leocelente/vedderb_bldc_hardware/design/BLDC_4.ods

Id | Designator | Footprint | Quantity | Designation | Supplier and ref
1 | D5 | do214ac | 1 | TVS 5V | 576-SMAJ5.0A
2 | C25,C33 | c_tant_B | 2 | 100u 6.3V | 581-TPSB107K006R0400
3 | C1,C8,C9,C40,C43,C44,C49 | SMD-1206 | 7 | 10u,50V | CAP SMD 1206
4 | C37 | c_2220 | 1 | 15u,100V | 810-CGA9P3X7S2A156M
5 | C51 | c_2220 | 1 | 15u, 100v | 810-CGA9P3X7S2A156M
6 | U2 | SOT-223 | 1 | TC2117 | 579-TC2117-3.3VDBTR
7 | R1 | SMD-0603_r | 1 | NTC 10k | 81-NCP18XH103F03RB
8 | R2,R20,R7,R8,R9,R10,R402 | SMD-0603_r | 7 | 10k | RES SMD 0603
9 | R17 | SMD-0603_r | 1 | 18k | RES SMD 0603
10 | R18 | SMD-0603_r | 1 | 3k3 | RES SMD 0603
11 | R19 | SMD-0603_r | 1 | 15k | RES SMD 0603
12 | R25 | SMD-0603_r | 1 | 1M | RES SMD 0603
13 | R28,R34,R42,R29,R35,R43 | SMD-0603_r | 6 | 4R7 | RES SMD 0603
14 | R48,R49,R50,R51,R16,R31,R37,R38 | SMD-0603_r | 8 | 100R | RES SMD 0603
15 | R103,R104 | SMD-0603_r | 2 | 22R | RES SMD 0603
16 | R401 | SMD-0603_r | 1 | 120R | RES SMD 0603
17 | R47,R39,R40,R45,R3,R23,R26,R30,R32,R36,R46 | SMD-0603_r | 11 | 39k | RES SMD 0603
18 | R4,R5,R11,R12,R13,R22,R24,R27,R33 | SMD-0603_r | 9 | 2k2 | RES SMD 0603
19 | R6 | SMD-0603_r | 1 | 0R | RES SMD 0603
20 | R21 | SMD-0603_r | 1 | 220k | RES SMD 0603
21 | R53,R52,R15,R14 | YLR2512_G4 | 4 | YLR12-3-8F-W
22 | Q1,Q3,Q5,Q6,Q2,Q4 | D2PAK-7-GDS | 6 | IRFS7530 | 942-IRFS7530TRL7PP
23 | K1 | PinHeader_1x03_P2.54mm_Horizontal | 1 | SERVO | Barra de pinos simples horizontal 2.54mm
24 | P2 | JST_PH_B6B-PH-K_1x06_P2.00mm_Vertical | 1 | SWD | JST PH 6 vias 2mm sinlge Vertical
25 | U1 | lqfp64_pad_mod | 1 | STM32F40X_LQFP64 | 511-STM32F405RGT6
26 | U3 | TSSOP-56-PP | 1 | DRV8302 | 595-DRV8302DCA
27 | P101 | JST_PH_S4B-PH-K_1x04_P2.00mm_Horizontal | 1 | CANBUS | JST PH 4 vias 2mm single horizontal
28 | C10,C11,C12,C13,C23,C35,C41,C401,C14,C16,C17,C18,C20,C24,C31,C52,C26 | SMD-0603_c | 17 | 2.2u 16V | 810-C1608X5R1C225M
29 | C19 | SMD-0603_c | 1 | 120p 50V | CAP SMD 0603
30 | C21 | SMD-0603_c | 1 | 6.8n 50V | CAP SMD 0603
31 | C22 | SMD-0603_c | 1 | 22n 50V | CAP SMD 0603
32 | C27,C47,C42,C2,C3,C32 | SMD-0603_c | 6 | 100n 50V | CAP SMD 0603
33 | C28,C29,C30 | SMD-0603_c | 3 | 220n 25V | CAP SMD 0603
34 | C34,C36 | SMD-0603_c | 2 | 2.2n 50V | CAP SMD 0603
35 | C39 | C_1206_3216Metric_Pad1.33x1.80mm_HandSolder | 1 | 10u,50V | 963-UMK316BBJ106ML-T
36 | U401 | SOIC-8-W | 1 | SN65HVD232DR
37 | X1 | USB-UX60R-MB-5ST | 1 | MINI-USB-SHIELD-32005-201 | 798-UX60R-MB-5ST
38 | P3 | JST_PH_S4B-PH-K_1x04_P2.00mm_Horizontal | 1 | PWR_COMM | JST PH 4 vias 2mm single horizontal
39 | L1 | inductor_smd_8x5mm | 1 | 22u | 652-SDR0805-220ML
40 | U8 | SOIC-8_3.9x4.9mm_P1.27mm | 1 | MAX485ED
41 | C45,C46 | SMD-0603_c | 2 | 10n 50V | CAP SMD 0603
42 | J3 | JST_PHD_S12B-PHDSS_2x06_P2.00mm_Horizontal | 1 | Conn_02x06_Odd_Even | JST PHD 12 vias 2mm duplo Horizontal
43 | U4,U7 | SOIC-8_3.9x4.9mm_P1.27mm | 2 | INA826AIDR
44 | J5,J4 | PinHeader_1x01_P1.00mm_Vertical | 2 | Conn_01x01_Pin | pin header 1 via vertical
45 | U5 | SOIC-16_3.9x9.9mm_P1.27mm | 1 | AM26C32CD
46 | FB1 | R_0805_2012Metric | 1 | FerriteBead | BLM31KN102SZ1L
47 | J1 | PhoenixContact_MSTBA_2,5_3-G-5,08_1x03_P5.08mm_Horizontal | 1 | Conn_01x03 | PhoenixContact_MSTBA_2,5_3-G-5,08_1x03_P5.08mm_Horizontal
48 | U6,U9 | SOT-23-5 | 2 | OPA333AIDBVR
49 | J6 | JST_PH_S2B-PH-K_1x02_P2.00mm_Horizontal | 1 | Conn_02x06_Odd_Even | JST PH 2 vias 2mm single horizontal
50 | J2 | PhoenixContact_MSTBA_2,5_2-G-5,08_1x02_P5.08mm_Horizontal | 1 | Conn_01x02 | PhoenixContact_MSTBA_2,5_2-G-5,08_1x02_P5.08mm_Horizontal
51 | D1 | LED-0603 | 1 | GREEN | LED GREEN 0603
52 | D2 | LED-0603 | 1 | RED | LED RED 0603
53 | D3 | LED-0603 | 1 | LED | LED yELLOW 0603
54 | X2 | Crystal_5x3mm | 1 | 8MHz 10ppm | 815-ABM3B-8.0-10-1UT
55 | C4,C5,C6,C7 | SMD-0603_c | 4 | 4n7 50V | CAP SMD 0603
56 | C15,C38 | SMD-0603_c | 2 | 15p 100V | CAP SMD 0603
57 | D4 | SMA_Handsoldering | 1 | DIODESCH | 771-PMEG6020ER-115
58 | R41,R44 | SMD-0603_r | 2 | 5.1K 0.1% | RT0603BRD075K1L
