leocelente/vedderb_bldc_hardware/design/BLDC_4.kicad_pcb

## KiCad design design/BLDC_4.kicad_pcb (2023-03-11)

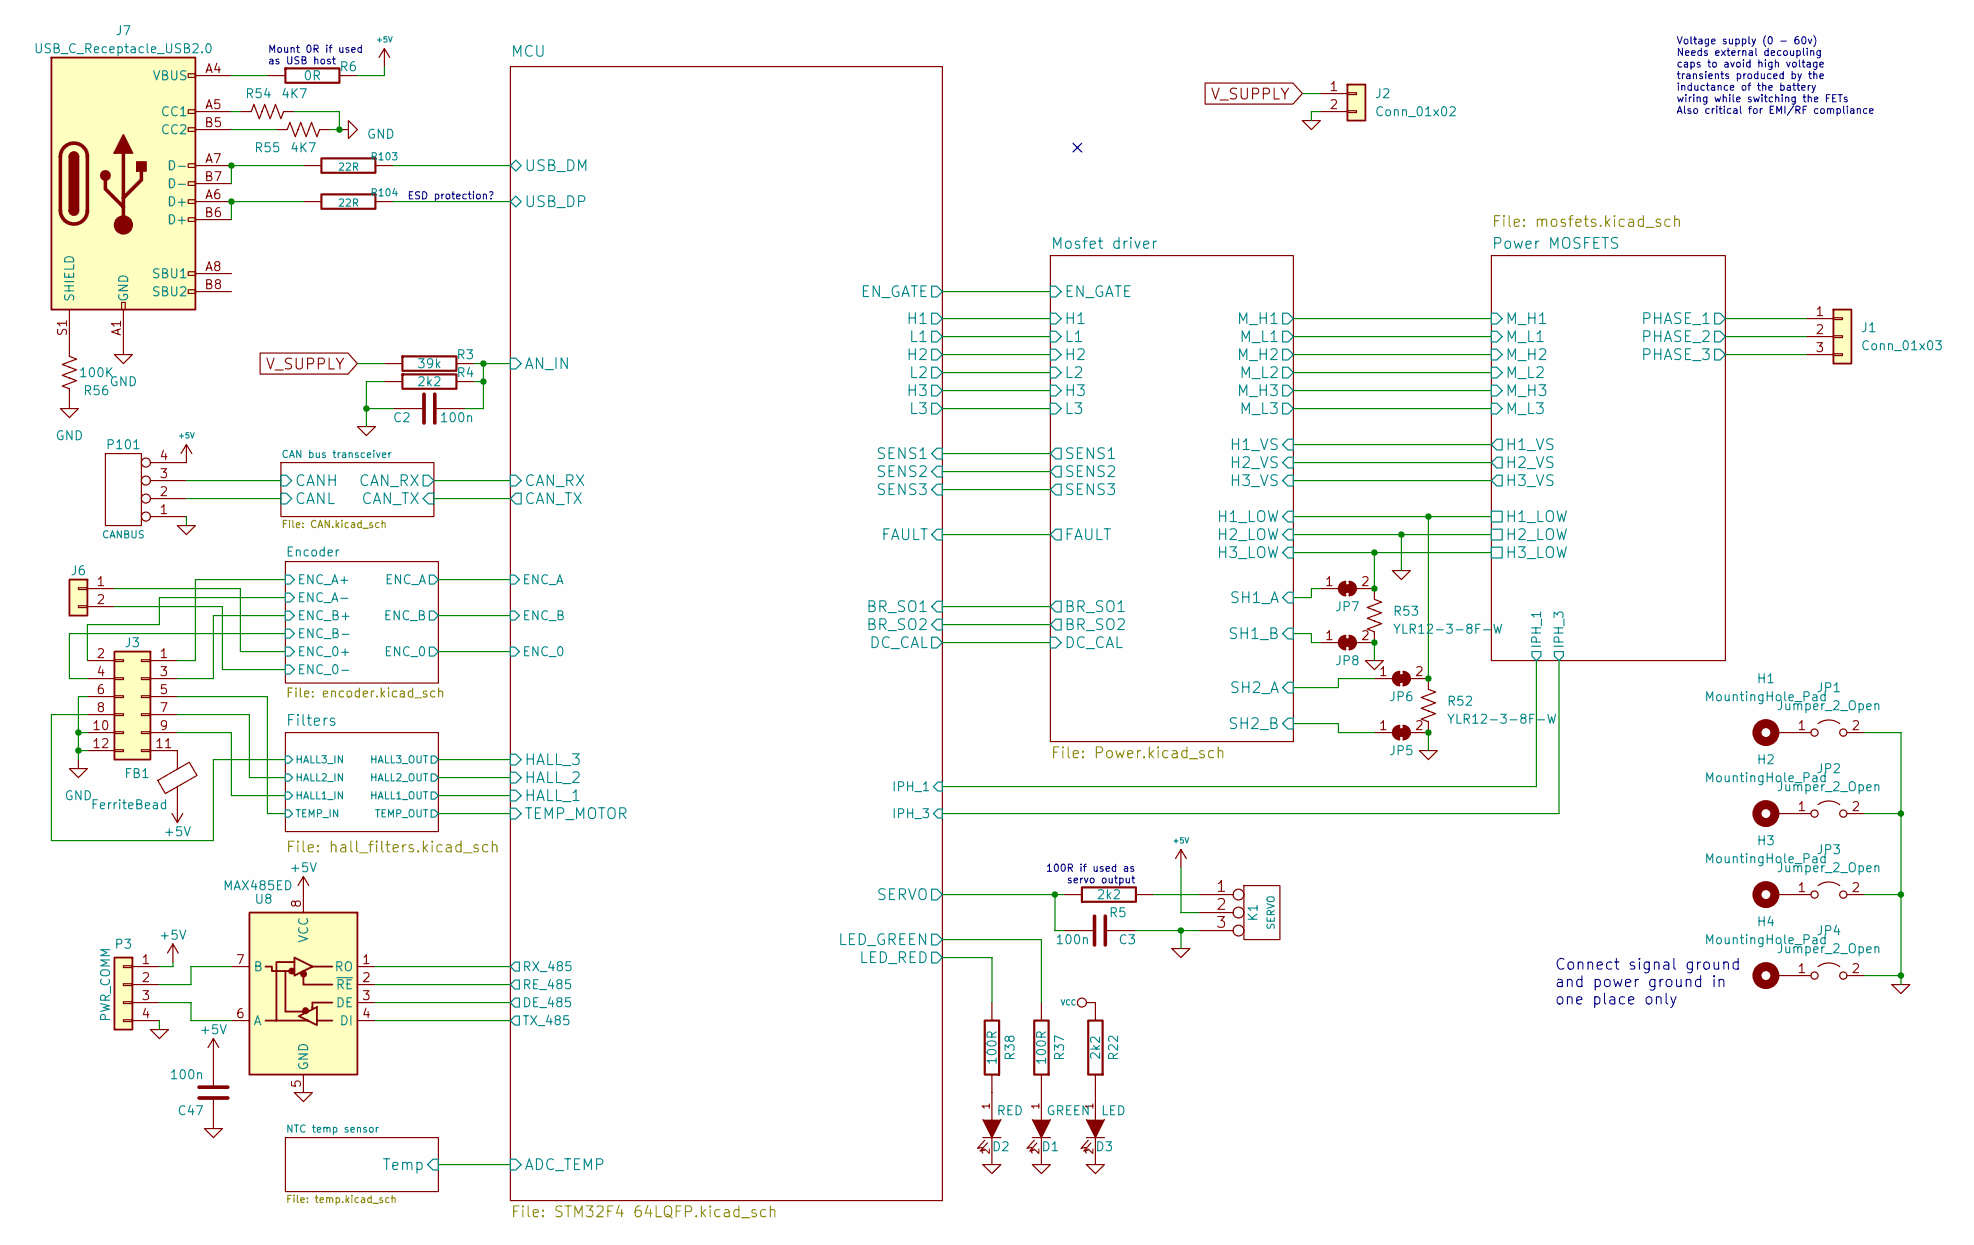
[picture p1: schematic BLDC_4.kicad_sch, BLDC Driver 4.11]

Parts:
C2, C3, C47: 100n; SMD-0603_c
D1: GREEN; LED-0603
D2: RED; LED-0603
D3: LED; LED-0603
FB1: FerriteBead; R_0805_2012Metric
H1, H2, H3, H4: MountingHole_Pad; MountingHole_3.2mm_M3_ISO7380_Pad
J1: Conn_01x03; PhoenixContact_MSTBA_2,5_3-G-5,08_1x03_P5.08mm_Horizontal
J2: Conn_01x02; PhoenixContact_MSTBA_2,5_2-G-5,08_1x02_P5.08mm_Horizontal
J3: Conn_02x06_Odd_Even; JST_PHD_S12B-PHDSS_2x06_P2.00mm_Horizontal
J6: Conn_02x06_Odd_Even; JST_PH_S2B-PH-K_1x02_P2.00mm_Horizontal
J7: USB_C_Receptacle_USB2.0; USB_C_Receptacle_G-Switch_GT-USB-7010ASV
JP1, JP2, JP3, JP4: Jumper_2_Open; SolderJumper-2_P1.3mm_Open_Pad1.0x1.5mm
JP5, JP6, JP7, JP8: SolderJumper_2_Bridged; MicroNetSep
K1: SERVO; PinHeader_1x03_P2.54mm_Horizontal
P3: PWR_COMM; JST_PH_S4B-PH-K_1x04_P2.00mm_Horizontal
P101: CANBUS; JST_PH_S4B-PH-K_1x04_P2.00mm_Horizontal
R3: 39k; SMD-0603_r
R4, R5, R22: 2k2; SMD-0603_r
R6: 0R; SMD-0603_r
R37, R38: 100R; SMD-0603_r
R52, R53: YLR12-3-8F-W; YLR2512_G4
R54, R55: 4K7; R_0603_1608Metric_Pad0.98x0.95mm_HandSolder
R56: 100K; R_0603_1608Metric_Pad0.98x0.95mm_HandSolder
R103, R104: 22R; SMD-0603_r
U8: MAX485ED; SOIC-8_3.9x4.9mm_P1.27mm

Connections:
+5V: C47.2, FB1.1, K1.2 (PM), P3.1, P101.4, R6.2, U8.8 (VCC); also elsewhere on the board
/CAN bus transceiver/CANH: P101.3; also elsewhere on the board
/CAN bus transceiver/CANL: P101.2; also elsewhere on the board
/Encoder/ENC_0+: J6.1; also elsewhere on the board
/Encoder/ENC_0-: J6.2; also elsewhere on the board
/Encoder/ENC_A+: J3.1; also elsewhere on the board
/Encoder/ENC_A-: J3.2; also elsewhere on the board
/Encoder/ENC_B+: J3.3; also elsewhere on the board
/Encoder/ENC_B-: J3.4; also elsewhere on the board
/Filters/HALL1_IN: J3.9; also elsewhere on the board
/Filters/HALL2_IN: J3.7; also elsewhere on the board
/Filters/HALL3_IN: J3.8; also elsewhere on the board
/Filters/TEMP_MOTOR: J3.5; also elsewhere on the board
/MCU/AN_IN: C2.2, R3.2, R4.2; also elsewhere on the board
/MCU/DE_485: U8.3 (DE); also elsewhere on the board
/MCU/LED_GREEN: R37.2; also elsewhere on the board
/MCU/LED_RED: R38.2; also elsewhere on the board
/MCU/RE_485: U8.2 (~RE); also elsewhere on the board
/MCU/RX_485: U8.1 (RO); also elsewhere on the board
/MCU/SERVO: C3.2, R5.1; also elsewhere on the board
/MCU/TX_485: U8.4 (DI); also elsewhere on the board
/MCU/USB_DM: R103.1; also elsewhere on the board
/MCU/USB_DP: R104.1; also elsewhere on the board
/Mosfet driver/H1_LOW: JP6.2 (B), R52.1; also elsewhere on the board
/Mosfet driver/H2_VS: J1.2; also elsewhere on the board
/Mosfet driver/SH1_A: JP7.1 (A); also elsewhere on the board
/Mosfet driver/SH2_A: JP6.1 (A); also elsewhere on the board
/Mosfet driver/SH2_B: JP5.1 (A); also elsewhere on the board
/Power MOSFETS/PHASE_1: J1.1; also elsewhere on the board
/Power MOSFETS/PHASE_3: J1.3; also elsewhere on the board
unnamed: D1.1 (A), R37.1
unnamed: D2.1 (A), R38.1
unnamed: D3.1 (A), R22.1
unnamed: FB1.2, J3.11
unnamed: J7.A5 (CC1), R54.1
unnamed: J7.B5 (CC2), R55.1
unnamed: J7.A6 (D+), J7.B6 (D+), R104.2
unnamed: J7.A7 (D-), J7.B7 (D-), R103.2
unnamed: J7.S1 (SHIELD), R56.2
unnamed: J7.A4 (VBUS), J7.A9 (VBUS), J7.B4 (VBUS), J7.B9 (VBUS), R6.1
unnamed: H1.1, JP1.1 (A)
unnamed: H2.1, JP2.1 (A)
unnamed: H3.1, JP3.1 (A)
unnamed: H4.1, JP4.1 (A)
unnamed: K1.1, R5.2
unnamed: P3.2, U8.7 (B)
unnamed: P3.3, U8.6 (A)
VCC: R22.2; also elsewhere on the board
V_SUPPLY: J2.1, R3.1; also elsewhere on the board

Notes on the sheet:
100R if used as servo output
Voltage supply (0 - 60v) Needs external decoupling caps to avoid high voltage transients produced by the inductance of the battery wiring while switching the FETs Also critical for EMI/RF compliance
Connect signal ground and power ground in one place only
Mount 0R if used as USB host
ESD protection?

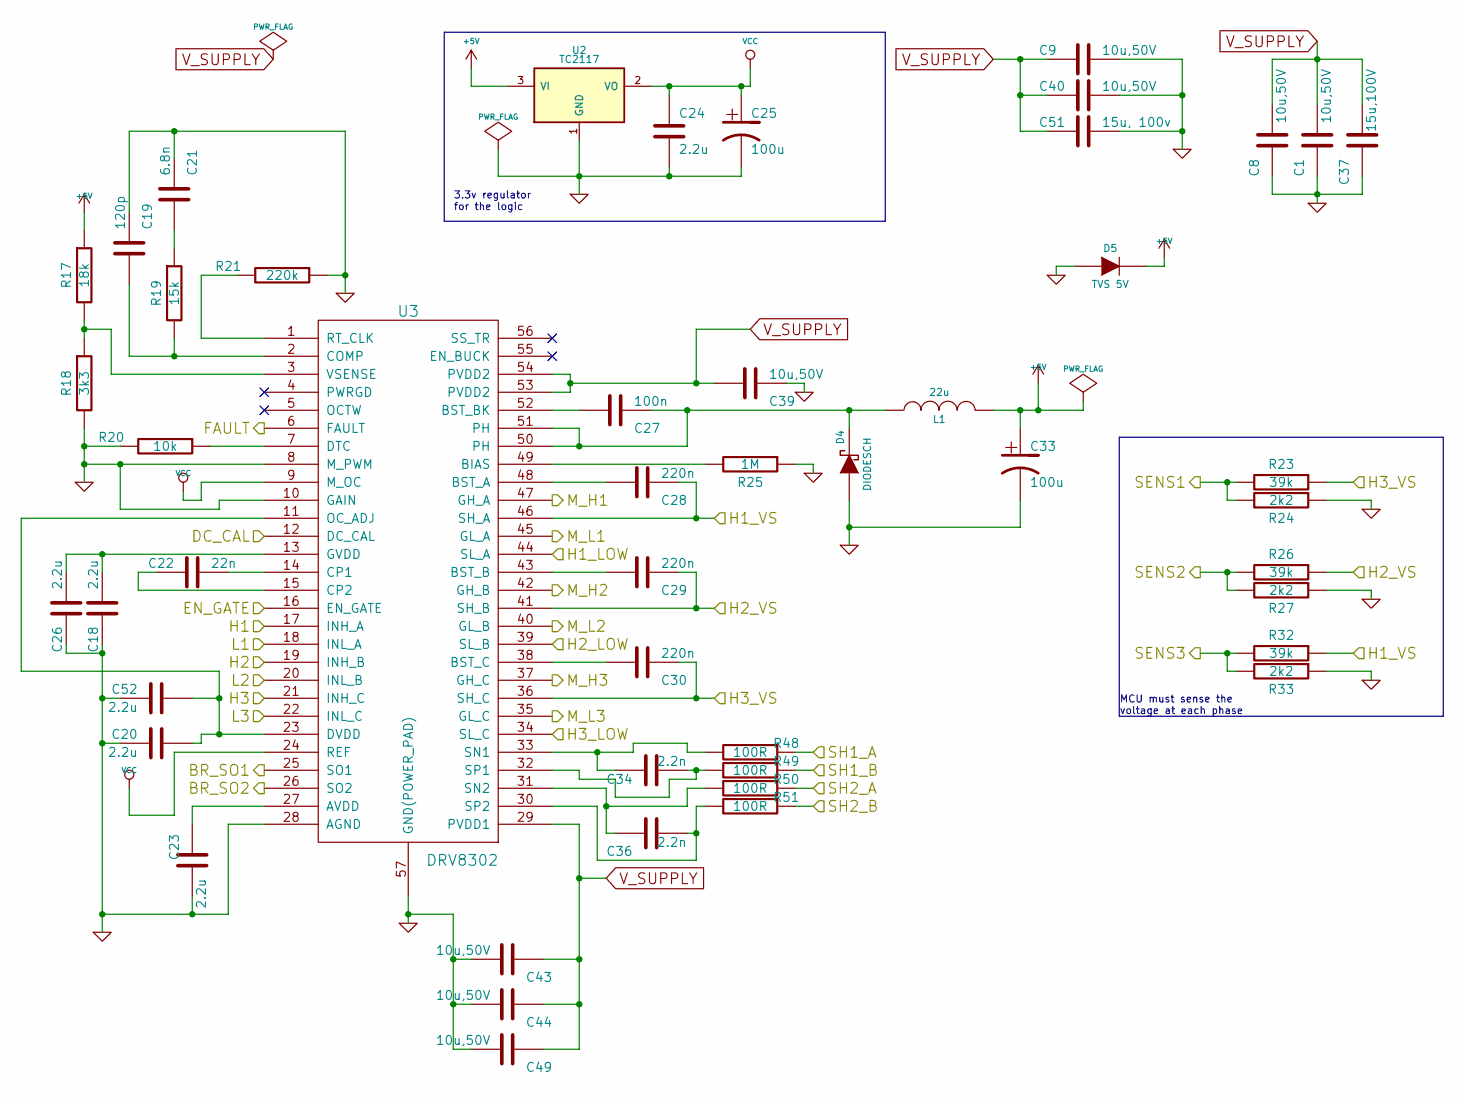
[picture p2: schematic Power.kicad_sch, BLDC Driver 4.11]

Parts:
C1, C8, C9, C40, C43, C44, C49: 10u,50V; SMD-1206
C18, C20, C23, C24, C26, C52: 2.2u; SMD-0603_c
C19: 120p; SMD-0603_c
C21: 6.8n; SMD-0603_c
C22: 22n; SMD-0603_c
C25, C33: 100u; c_tant_B
C27: 100n; SMD-0603_c
C28, C29, C30: 220n; SMD-0603_c
C34, C36: 2.2n; SMD-0603_c
C37: 15u,100V; c_2220
C39: 10u,50V; C_1206_3216Metric_Pad1.33x1.80mm_HandSolder
C51: 15u, 100v; c_2220
D4: DIODESCH; SMA_Handsoldering
D5: TVS 5V; do214ac
L1: 22u; inductor_smd_8x5mm
R17: 18k; SMD-0603_r
R18: 3k3; SMD-0603_r
R19: 15k; SMD-0603_r
R20: 10k; SMD-0603_r
R21: 220k; SMD-0603_r
R23, R26, R32: 39k; SMD-0603_r
R24, R27, R33: 2k2; SMD-0603_r
R25: 1M; SMD-0603_r
R48, R49, R50, R51: 100R; SMD-0603_r
U2: TC2117; SOT-223
U3: DRV8302; TSSOP-56-PP

Connections:
+5V: C33.1, D5.2 (K), L1.2, R17.1, U2.3 (VI); also elsewhere on the board
/MCU/BR_SO1: U3.25 (SO1); also elsewhere on the board
/MCU/BR_SO2: U3.26 (SO2); also elsewhere on the board
/MCU/DC_CAL: U3.12 (DC_CAL); also elsewhere on the board
/MCU/EN_GATE: U3.16 (EN_GATE); also elsewhere on the board
/MCU/FAULT: U3.6 (FAULT); also elsewhere on the board
/MCU/H1: U3.17 (INH_A); also elsewhere on the board
/MCU/H2: U3.19 (INH_B); also elsewhere on the board
/MCU/H3: U3.21 (INH_C); also elsewhere on the board
/MCU/L1: U3.18 (INL_A); also elsewhere on the board
/MCU/L2: U3.20 (INL_B); also elsewhere on the board
/MCU/L3: U3.22 (INL_C); also elsewhere on the board
/MCU/SENS1: R23.2, R24.2; also elsewhere on the board
/MCU/SENS2: R26.2, R27.2; also elsewhere on the board
/MCU/SENS3: R32.2, R33.2; also elsewhere on the board
/Mosfet driver/H1_LOW: U3.44 (SL_A); also elsewhere on the board
/Mosfet driver/H2_VS: C29.1, R26.1, U3.41 (SH_B); also elsewhere on the board
/Mosfet driver/M_H1: U3.47 (GH_A); also elsewhere on the board
/Mosfet driver/M_H2: U3.42 (GH_B); also elsewhere on the board
/Mosfet driver/M_H3: U3.37 (GH_C); also elsewhere on the board
/Mosfet driver/M_L1: U3.45 (GL_A); also elsewhere on the board
/Mosfet driver/M_L2: U3.40 (GL_B); also elsewhere on the board
/Mosfet driver/M_L3: U3.35 (GL_C); also elsewhere on the board
/Mosfet driver/SH1_A: R48.1; also elsewhere on the board
/Mosfet driver/SH2_A: R50.1; also elsewhere on the board
/Mosfet driver/SH2_B: R51.1; also elsewhere on the board
unnamed: C21.2, R19.1
unnamed: C27.1, D4.2 (K), L1.1, U3.50 (PH), U3.51 (PH)
unnamed: C23.2, U3.27 (AVDD)
unnamed: R25.2, U3.49 (BIAS)
unnamed: C28.2, U3.48 (BST_A)
unnamed: C29.2, U3.43 (BST_B)
unnamed: C27.2, U3.52 (BST_BK)
unnamed: C30.2, U3.38 (BST_C)
unnamed: C19.2, R19.2, U3.2 (COMP)
unnamed: C22.1, U3.14 (CP1)
unnamed: C22.2, U3.15 (CP2)
unnamed: R20.1, U3.7 (DTC)
unnamed: C20.2, C52.2, U3.11 (OC_ADJ), U3.23 (DVDD)
unnamed: C18.1, C26.1, U3.13 (GVDD)
unnamed: R21.2, U3.1 (RT_CLK)
unnamed: C34.1, R48.2, U3.33 (SN1)
unnamed: C36.1, R50.2, U3.31 (SN2)
unnamed: C34.2, R49.2, U3.32 (SP1)
unnamed: C36.2, R51.2, U3.30 (SP2)
unnamed: R17.2, R18.1, U3.3 (VSENSE)
VCC: C24.1, C25.1, U2.2 (VO), U3.9 (M_OC), U3.24 (REF); also elsewhere on the board
V_SUPPLY: C1.2, C8.2, C9.2, C37.2, C39.2, C40.2, C43.1, C44.1, C49.1, C51.2, U3.29 (PVDD1), U3.53 (PVDD2), U3.54 (PVDD2); also elsewhere on the board

Notes on the sheet:
3.3v regulator for the logic
MCU must sense the voltage at each phase

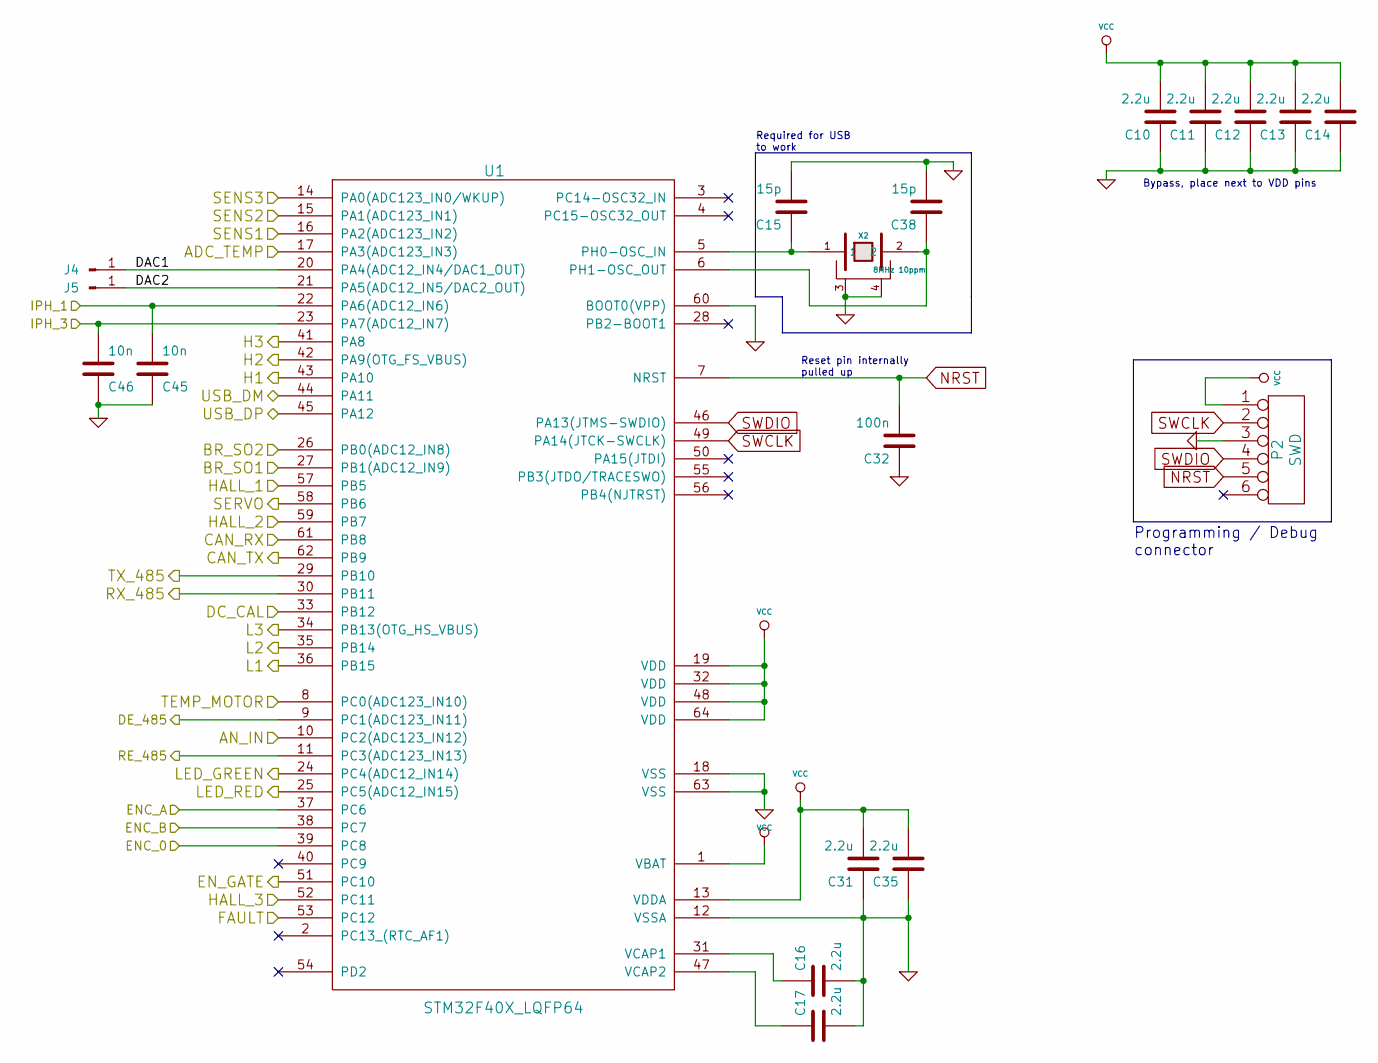
[picture p3: schematic STM32F4 64LQFP.kicad_sch, BLDC Driver 4.11]

Parts:
C10, C11, C12, C13, C14, C16, C17, C31, C35: 2.2u; SMD-0603_c
C15, C38: 15p; SMD-0603_c
C32: 100n; SMD-0603_c
C45, C46: 10n; SMD-0603_c
J4, J5: Conn_01x01_Pin; PinHeader_1x01_P1.00mm_Vertical
P2: SWD; JST_PH_B6B-PH-K_1x06_P2.00mm_Vertical
U1: STM32F40X_LQFP64; lqfp64_pad_mod
X2: 8MHz 10ppm; Crystal_5x3mm; mfg# ABM3B-8.0-10-1UT

Connections:
/CAN bus transceiver/CAN_RX: U1.61 (PB8); also elsewhere on the board
/CAN bus transceiver/CAN_TX: U1.62 (PB9); also elsewhere on the board
/Encoder/ENC_0: U1.39 (PC8); also elsewhere on the board
/Encoder/ENC_A: U1.37 (PC6); also elsewhere on the board
/Encoder/ENC_B: U1.38 (PC7); also elsewhere on the board
/Filters/HALL1_OUT: U1.57 (PB5); also elsewhere on the board
/Filters/HALL2_OUT: U1.59 (PB7); also elsewhere on the board
/Filters/HALL3_OUT: U1.52 (PC11); also elsewhere on the board
/Filters/TEMP_MOTOR: U1.8 (PC0(ADC123_IN10)); also elsewhere on the board
/MCU/ADC_TEMP: U1.17 (PA3(ADC123_IN3)); also elsewhere on the board
/MCU/AN_IN: U1.10 (PC2(ADC123_IN12)); also elsewhere on the board
/MCU/BR_SO1: U1.27 (PB1(ADC12_IN9)); also elsewhere on the board
/MCU/BR_SO2: U1.26 (PB0(ADC12_IN8)); also elsewhere on the board
/MCU/DAC1: J4.1, U1.20 (PA4(ADC12_IN4/DAC1_OUT))
/MCU/DAC2: J5.1, U1.21 (PA5(ADC12_IN5/DAC2_OUT))
/MCU/DC_CAL: U1.33 (PB12); also elsewhere on the board
/MCU/DE_485: U1.9 (PC1(ADC123_IN11)); also elsewhere on the board
/MCU/EN_GATE: U1.51 (PC10); also elsewhere on the board
/MCU/FAULT: U1.53 (PC12); also elsewhere on the board
/MCU/H1: U1.43 (PA10); also elsewhere on the board
/MCU/H2: U1.42 (PA9(OTG_FS_VBUS)); also elsewhere on the board
/MCU/H3: U1.41 (PA8); also elsewhere on the board
/MCU/IPH_1: C45.2, U1.22 (PA6(ADC12_IN6)); also elsewhere on the board
/MCU/IPH_3: C46.2, U1.23 (PA7(ADC12_IN7)); also elsewhere on the board
/MCU/L1: U1.36 (PB15); also elsewhere on the board
/MCU/L2: U1.35 (PB14); also elsewhere on the board
/MCU/L3: U1.34 (PB13(OTG_HS_VBUS)); also elsewhere on the board
/MCU/LED_GREEN: U1.24 (PC4(ADC12_IN14)); also elsewhere on the board
/MCU/LED_RED: U1.25 (PC5(ADC12_IN15)); also elsewhere on the board
/MCU/RE_485: U1.11 (PC3(ADC123_IN13)); also elsewhere on the board
/MCU/RX_485: U1.30 (PB11); also elsewhere on the board
/MCU/SENS1: U1.16 (PA2(ADC123_IN2)); also elsewhere on the board
/MCU/SENS2: U1.15 (PA1(ADC123_IN1)); also elsewhere on the board
/MCU/SENS3: U1.14 (PA0(ADC123_IN0/WKUP)); also elsewhere on the board
/MCU/SERVO: U1.58 (PB6); also elsewhere on the board
/MCU/TX_485: U1.29 (PB10); also elsewhere on the board
/MCU/USB_DM: U1.44 (PA11); also elsewhere on the board
/MCU/USB_DP: U1.45 (PA12); also elsewhere on the board
NRST: C32.2, P2.5, U1.7 (NRST)
unnamed: C15.1, U1.5 (PH0-OSC_IN), X2.1
unnamed: C38.1, U1.6 (PH1-OSC_OUT), X2.2
unnamed: C16.1, U1.31 (VCAP1)
unnamed: C17.1, U1.47 (VCAP2)
SWCLK: P2.2, U1.49 (PA14(JTCK-SWCLK))
SWDIO: P2.4, U1.46 (PA13(JTMS-SWDIO))
VCC: C10.2, C11.2, C12.2, C13.2, C14.2, C31.2, C35.2, P2.1, U1.1 (VBAT), U1.13 (VDDA), U1.19 (VDD), U1.32 (VDD), U1.48 (VDD), U1.64 (VDD); also elsewhere on the board

Notes on the sheet:
Bypass, place next to VDD pins
Required for USB to work
Programming / Debug connector
Reset pin internally pulled up

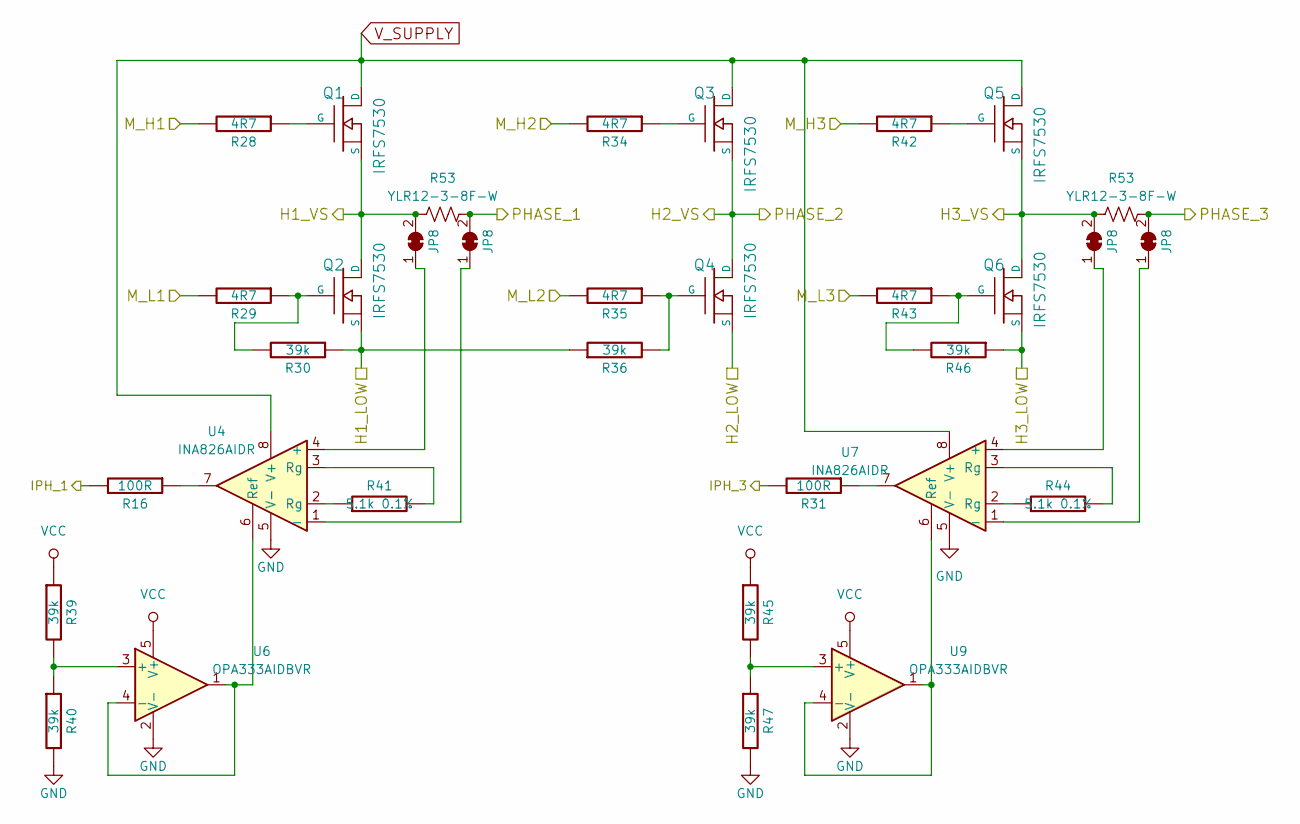
[picture p4: schematic mosfets.kicad_sch, BLDC Driver 4.11]

Parts:
JP8: SolderJumper_2_Bridged; MicroNetSep
Q1, Q2, Q3, Q4, Q5, Q6: IRFS7530; D2PAK-7-GDS
R16, R31: 100R; SMD-0603_r
R28, R29, R34, R35, R42, R43: 4R7; SMD-0603_r
R30, R36, R39, R40, R45, R46, R47: 39k; SMD-0603_r
R41, R44: 5.1k 0.1%; SMD-0603_r
R53: YLR12-3-8F-W; YLR2512_G4
U4, U7: INA826AIDR; SOIC-8_3.9x4.9mm_P1.27mm
U6, U9: OPA333AIDBVR; SOT-23-5

Connections:
/MCU/IPH_1: R16.2; also elsewhere on the board
/MCU/IPH_3: R31.2; also elsewhere on the board
/Mosfet driver/H1_LOW: Q2.S, R30.1, R36.1; also elsewhere on the board
/Mosfet driver/H2_VS: Q3.S, Q4.D; also elsewhere on the board
/Mosfet driver/M_H1: R28.2; also elsewhere on the board
/Mosfet driver/M_H2: R34.2; also elsewhere on the board
/Mosfet driver/M_H3: R42.2; also elsewhere on the board
/Mosfet driver/M_L1: R29.2; also elsewhere on the board
/Mosfet driver/M_L2: R35.2; also elsewhere on the board
/Mosfet driver/M_L3: R43.2; also elsewhere on the board
unnamed: Q1.G, R28.1
unnamed: Q2.G, R29.1, R30.2
unnamed: Q3.G, R34.1
unnamed: Q4.G, R35.1, R36.2
unnamed: Q5.G, R42.1
unnamed: Q6.G, R43.1, R46.2
unnamed: R16.1, U4.7
unnamed: R31.1, U7.7
unnamed: R41.1, U4.2 (Rg)
unnamed: R41.2, U4.3 (Rg)
unnamed: R44.1, U7.2 (Rg)
unnamed: R44.2, U7.3 (Rg)
unnamed: U4.6 (Ref), U6.1, U6.4 (-)
unnamed: R39.2, R40.1, U6.3 (+)
unnamed: U7.6 (Ref), U9.1, U9.4 (-)
unnamed: R45.2, R47.1, U9.3 (+)
VCC: R39.1, R45.1, U6.5 (V+), U9.5 (V+); also elsewhere on the board
V_SUPPLY: Q1.D, Q3.D, Q5.D, U4.8 (V+), U7.8 (V+); also elsewhere on the board

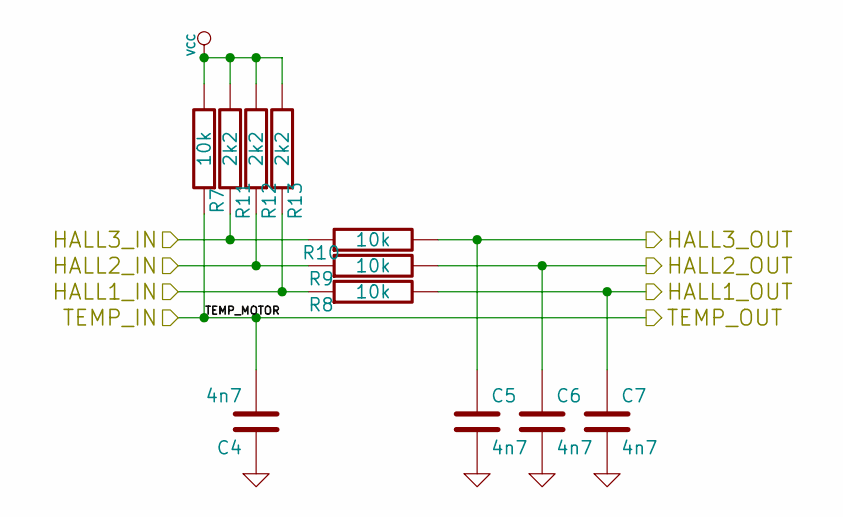
[picture p5: schematic hall_filters.kicad_sch, BLDC Driver 4.11]

Parts:
C4, C5, C6, C7: 4n7; SMD-0603_c
R7, R8, R9, R10: 10k; SMD-0603_r
R11, R12, R13: 2k2; SMD-0603_r

Connections:
/Filters/HALL1_IN: R8.1, R13.1; also elsewhere on the board
/Filters/HALL1_OUT: C7.1, R8.2; also elsewhere on the board
/Filters/HALL2_IN: R9.1, R12.1; also elsewhere on the board
/Filters/HALL2_OUT: C6.1, R9.2; also elsewhere on the board
/Filters/HALL3_IN: R10.1, R11.1; also elsewhere on the board
/Filters/HALL3_OUT: C5.1, R10.2; also elsewhere on the board
/Filters/TEMP_MOTOR: C4.2, R7.1; also elsewhere on the board
VCC: R7.2, R11.2, R12.2, R13.2; also elsewhere on the board


Parts:
C41: 2.2u; SMD-0603_c
R1: NTC 10k; SMD-0603_r
R2: 10k; SMD-0603_r

Connections:
/MCU/ADC_TEMP: C41.1, R1.2, R2.1; also elsewhere on the board
VCC: R1.1; also elsewhere on the board


Parts:
C401: 2.2u; SMD-0603_c
R401: NI; SMD-0603_r
R402: 10k; SMD-0603_r
U401: SN65HVD232; SOIC-8-W

Connections:
/CAN bus transceiver/CANH: R401.1, U401.7 (CANH); also elsewhere on the board
/CAN bus transceiver/CANL: R401.2, U401.6 (CANL); also elsewhere on the board
/CAN bus transceiver/CAN_RX: U401.4 (RXD); also elsewhere on the board
/CAN bus transceiver/CAN_TX: U401.1 (TXD); also elsewhere on the board
unnamed: R402.1, U401.8 (Rs)
VCC: C401.1, U401.3 (VDD); also elsewhere on the board

Notes on the sheet:
Propagation delay resistor

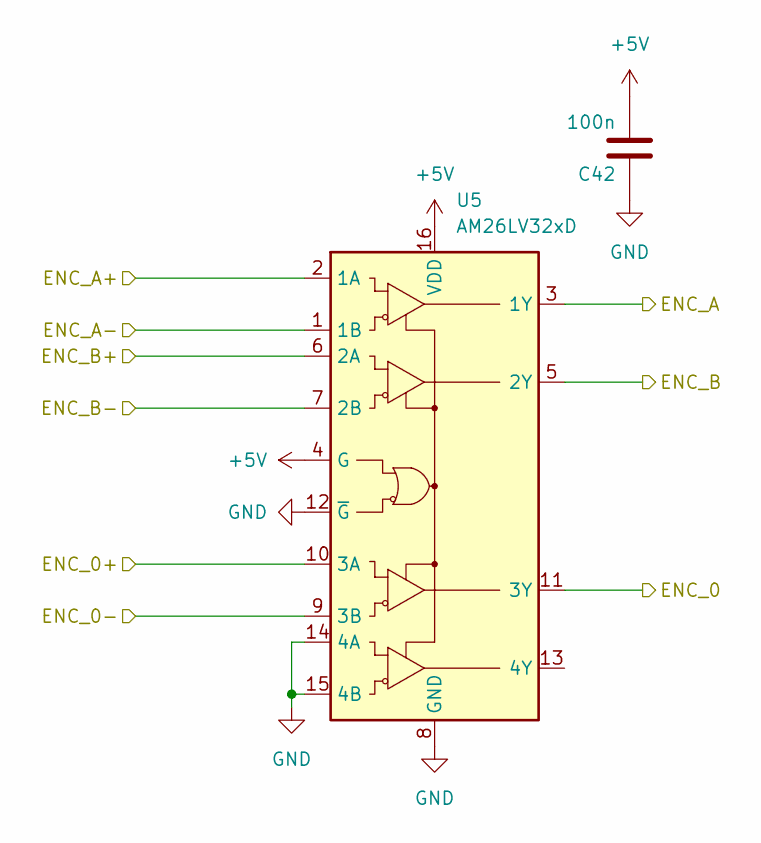
[picture p8: schematic encoder.kicad_sch]

Parts:
C42: 100n; SMD-0603_c
U5: AM26LV32xD; SOIC-16_3.9x9.9mm_P1.27mm

Connections:
+5V: C42.2, U5.4 (G), U5.16 (VDD); also elsewhere on the board
/Encoder/ENC_0: U5.11 (3Y); also elsewhere on the board
/Encoder/ENC_0+: U5.10 (3A); also elsewhere on the board
/Encoder/ENC_0-: U5.9 (3B); also elsewhere on the board
/Encoder/ENC_A: U5.3 (1Y); also elsewhere on the board
/Encoder/ENC_A+: U5.2 (1A); also elsewhere on the board
/Encoder/ENC_A-: U5.1 (1B); also elsewhere on the board
/Encoder/ENC_B: U5.5 (2Y); also elsewhere on the board
/Encoder/ENC_B+: U5.6 (2A); also elsewhere on the board
/Encoder/ENC_B-: U5.7 (2B); also elsewhere on the board

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
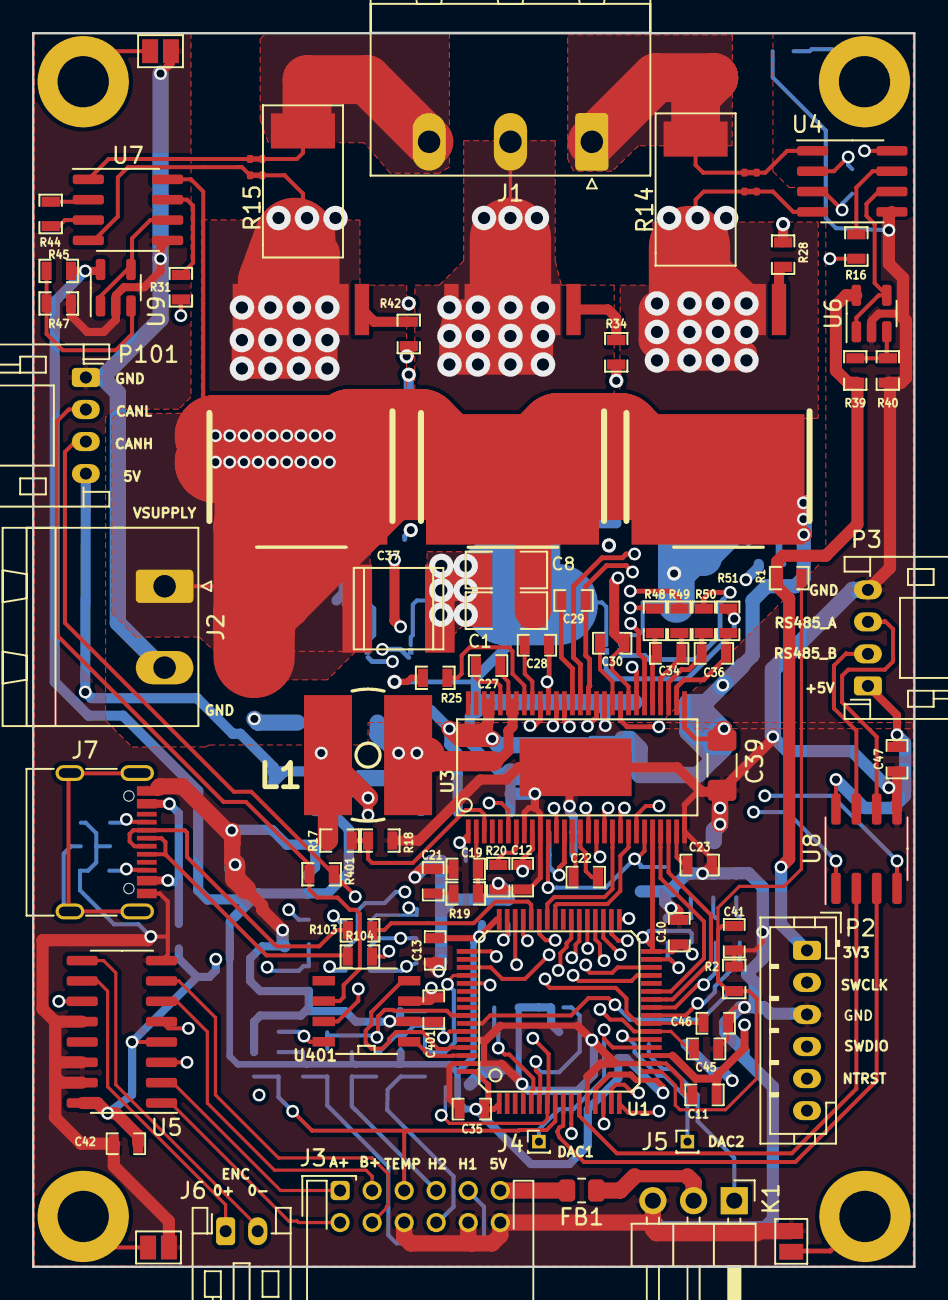
[picture p9: board BLDC_4.kicad_pcb from above]

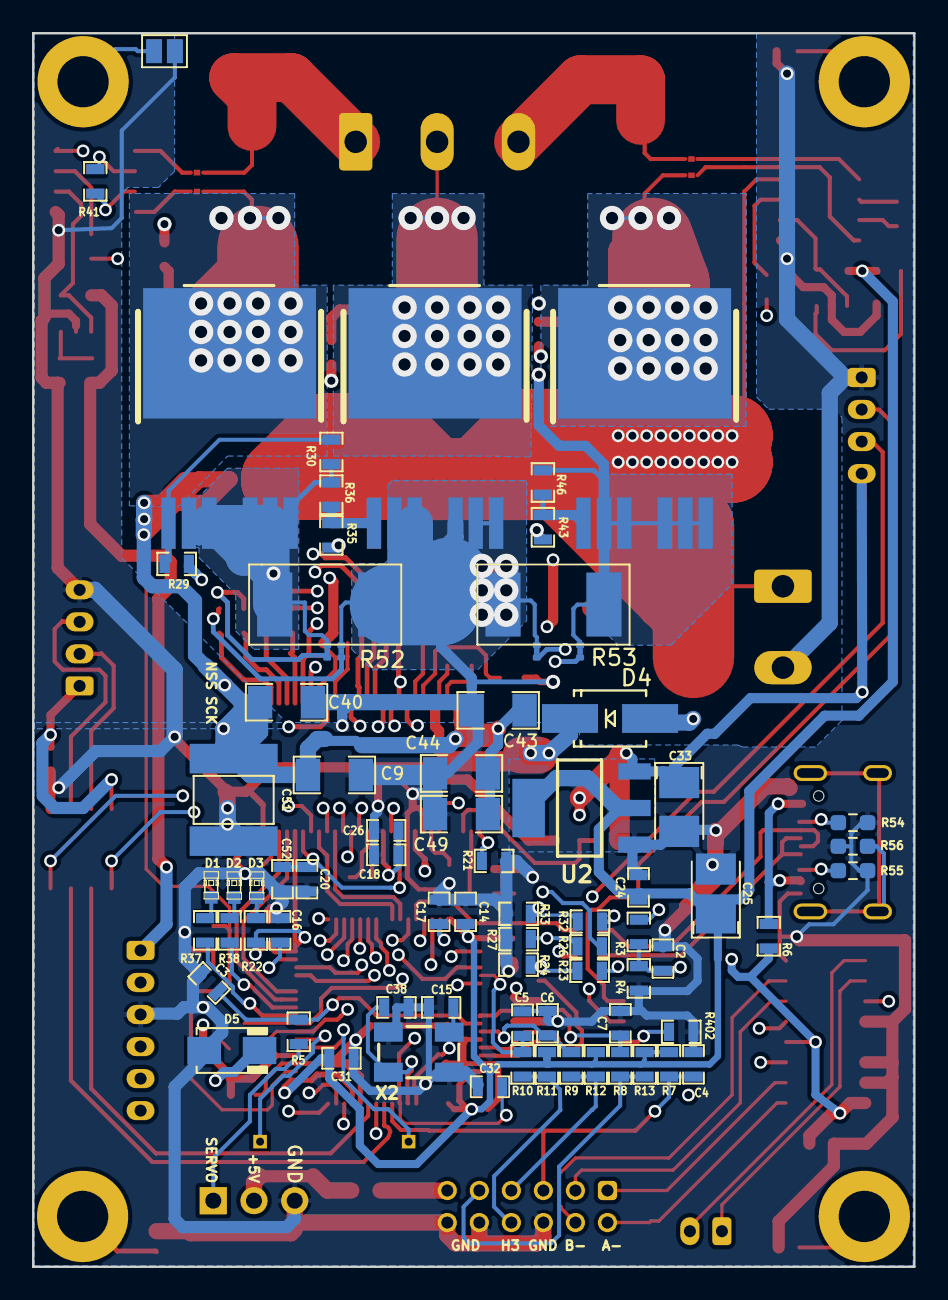
[picture p10: board BLDC_4.kicad_pcb from below]

Board: 4 copper layers, 55.0 x 77.0 mm, 162 parts (75 on the bottom side), 135 nets.

Other parts of the board:
JP9, JP10, JP11, JP12: SolderJumper_2_Bridged; MicroNetSep
R14, R15: YLR12-3-8F-W; YLR2512_G4

Their connections:
/Power MOSFETS/PHASE_1: JP11.2 (B), R14.2; also elsewhere on the board
/Power MOSFETS/PHASE_3: JP10.2 (B), R15.2; also elsewhere on the board
