leocelente/vedderb_bldc_hardware/(commit log)

2023-01-20 Going to KiCAD 6
    [BLDC_4.kicad_pcb]
2023-02-25 Moving to KICAD 6
    [BLDC_4.kicad_pcb, BLDC_4.kicad_sch, BLDC_4.sch, CAN.kicad_sch, CAN.sch, Power.kicad_sch, Power.sch, STM32F4 64LQFP.kicad_sch]
2023-02-26 STM pins connected
    [BLDC_4.kicad_pcb, BLDC_4.kicad_sch, CAN.kicad_sch, Power.kicad_sch, STM32F4 64LQFP.kicad_sch, encoder.kicad_sch, hall_filters.kicad_sch, mosfets.kicad_sch]
2023-02-27 Última versão de hoje
    [BLDC_4.kicad_pcb, BLDC_4.kicad_sch, STM32F4 64LQFP.kicad_sch]
2023-02-28 Corrigindo Footprints com silk nos pads
2023-02-28 Limpando warnings e DRC errors
    [BLDC_4.kicad_pcb, Power.kicad_sch]
2023-02-28 Don't need to track gerbers!
    [BLDC_4-B_Cu.gbl, BLDC_4-B_Mask.gbs, BLDC_4-B_Paste.gbp, BLDC_4-B_SilkS.gbo, BLDC_4-Edge_Cuts.gm1, BLDC_4-F_Cu.gtl, BLDC_4-F_Mask.gts, BLDC_4-F_Paste.gtp]
2023-02-28 Bill of materials
    [BLDC_4.ods]
2023-02-28 Final 20230228
    [BLDC_4.kicad_pcb, BLDC_4.kicad_sch, Power.kicad_sch, mosfets.kicad_sch]
2023-03-01 Fixing voltage supply of INA826 to read phase current value
    [BLDC_4.kicad_pcb, BLDC_4.ods, mosfets.kicad_sch]
2023-03-06 Fixing mini-USB connector pinout
    [BLDC_4.kicad_pcb]
2023-03-07 Changing to USB-C connector
    [BLDC_4.kicad_pcb, BLDC_4.kicad_sch]
2023-03-11 Swapped SERVO and SENS1 pins
    [BLDC_4.kicad_pcb, STM32F4 64LQFP.kicad_sch]
